Akhmadi14/Electro-Fenton-Reactor/presentasi/EFfiton_Poster_EEdays.jpeg

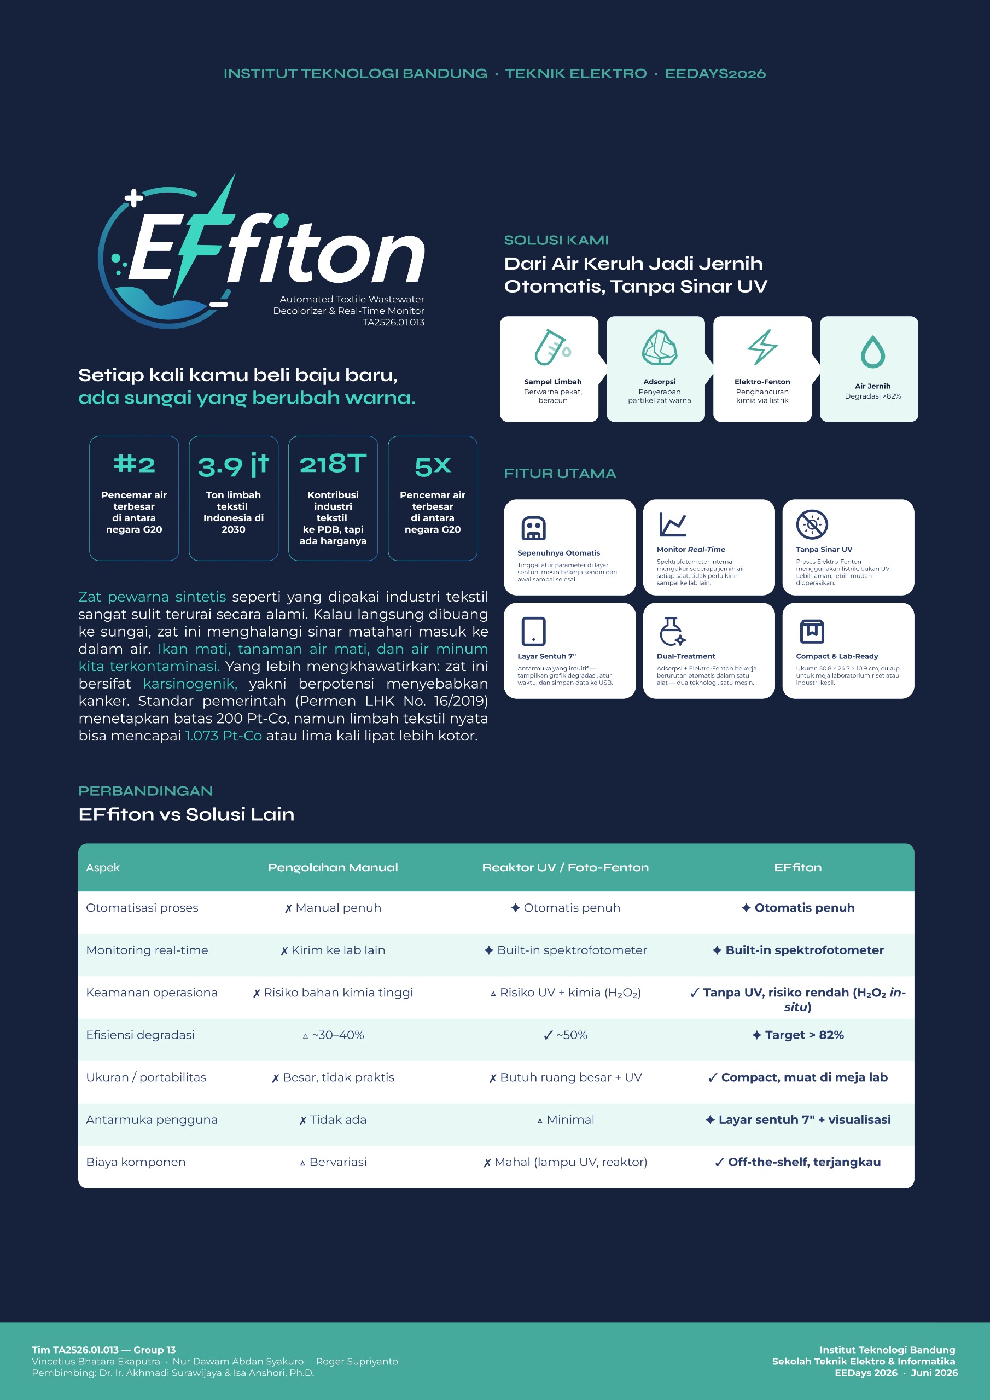
presentasi/EFfiton_Poster_EEdays.jpeg
