Akhmadi14/Electro-Fenton-Reactor/Rancangan/program_mikrokontroller/Reference/flowchart_pompa/alur_pompa-aerator.drawio.png

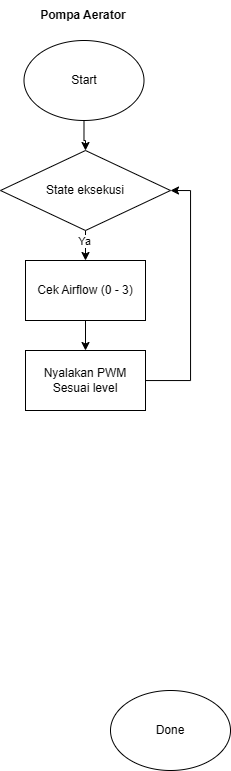
Rancangan/program_mikrokontroller/Reference/flowchart_pompa/alur_pompa-aerator.drawio.png
