Akhmadi14/Electro-Fenton-Reactor/Rancangan/program_mikrokontroller/Reference/flowchart_pompa/alur_pompa-h2so4.drawio.png

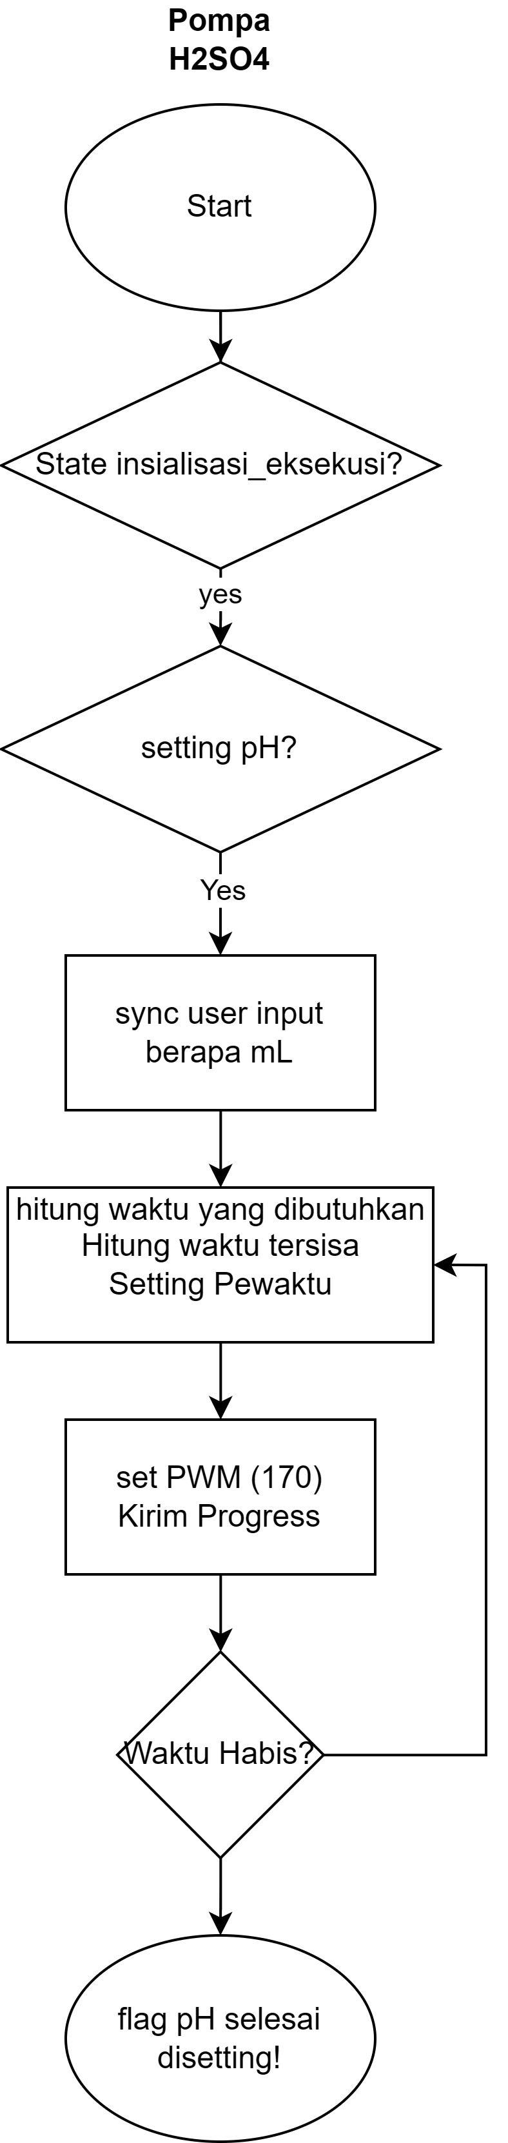
Rancangan/program_mikrokontroller/Reference/flowchart_pompa/alur_pompa-h2so4.drawio.png
