Akhmadi14/Electro-Fenton-Reactor/Rancangan/program_mikrokontroller/Reference/flowchart_pompa/flowchart_feso4.png

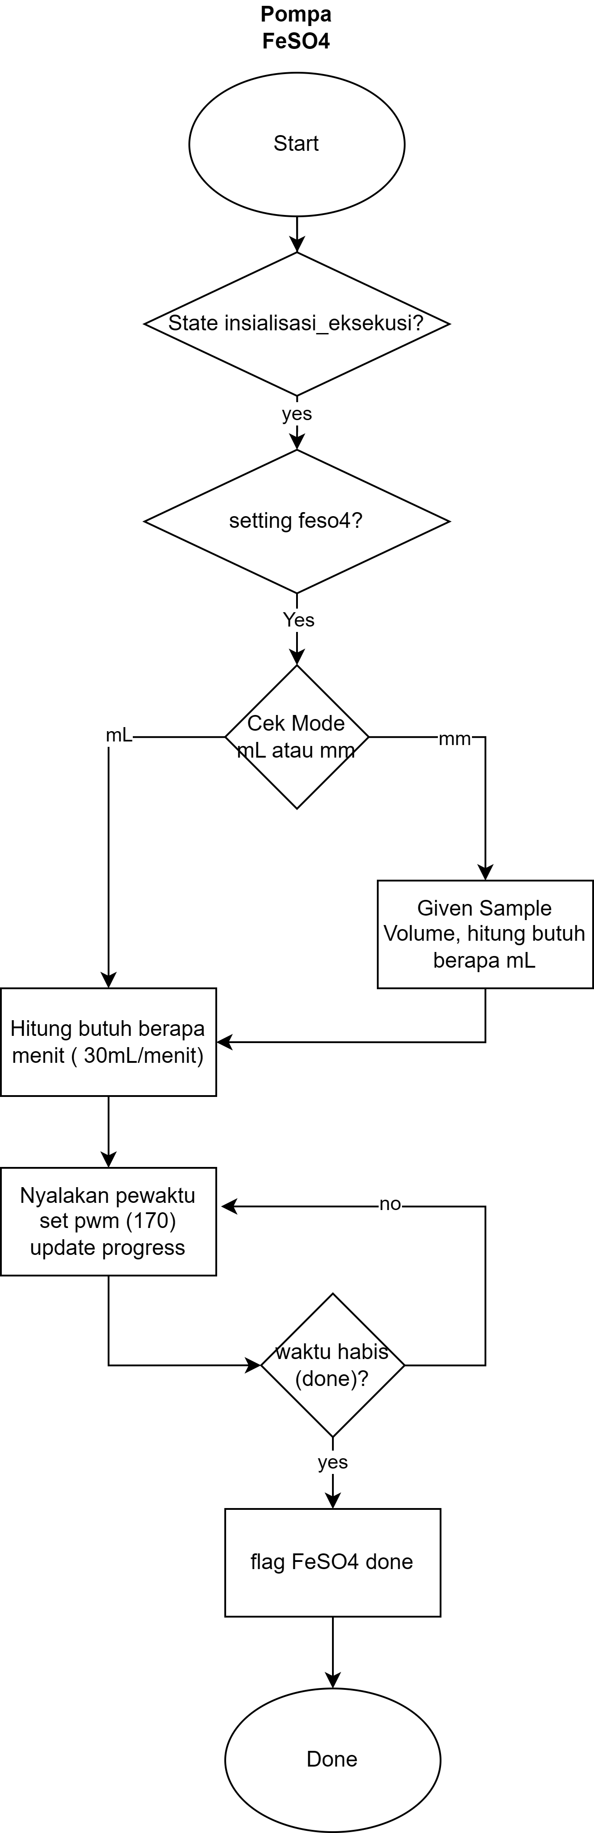
Rancangan/program_mikrokontroller/Reference/flowchart_pompa/flowchart_feso4.png
