Akhmadi14/Electro-Fenton-Reactor/Rancangan/program_mikrokontroller/Reference/state_eksekusi.png

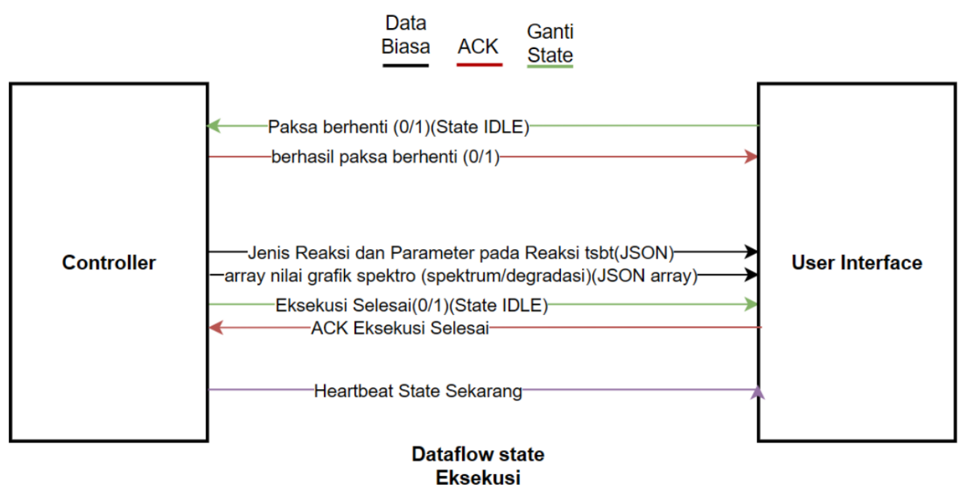
Rancangan/program_mikrokontroller/Reference/state_eksekusi.png
