Akhmadi14/Electro-Fenton-Reactor/Rancangan/program_mikrokontroller/Reference/state_flushing.png

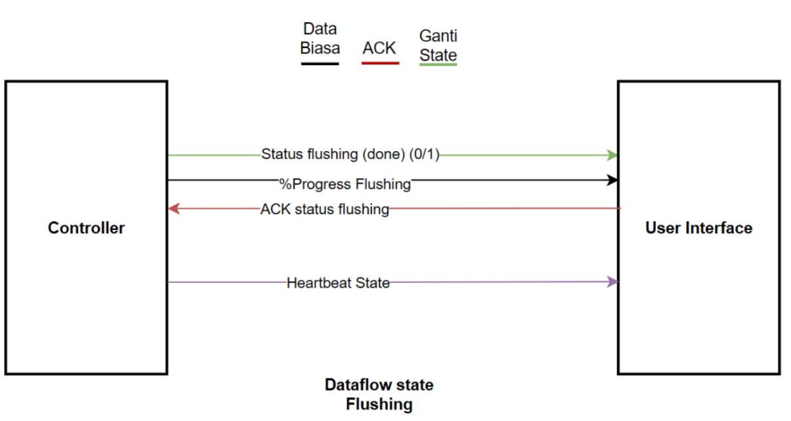
Rancangan/program_mikrokontroller/Reference/state_flushing.png
