Akhmadi14/Electro-Fenton-Reactor/Rancangan/program_mikrokontroller/Reference/state_idle.png

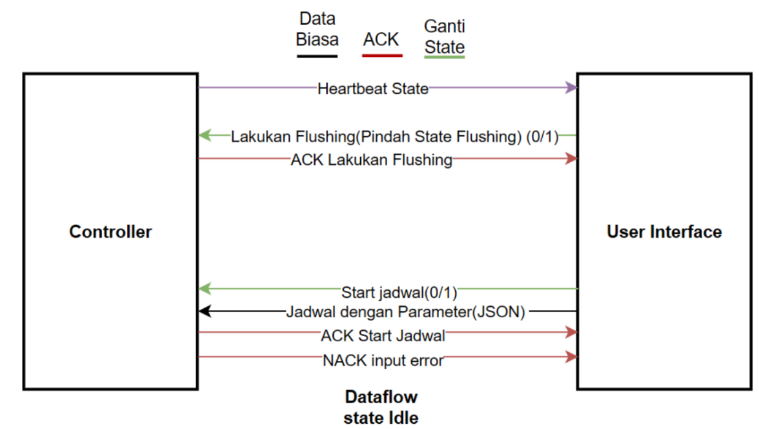
Rancangan/program_mikrokontroller/Reference/state_idle.png
