Akhmadi14/Electro-Fenton-Reactor/Rancangan/program_mikrokontroller/Reference/state_sistem.png

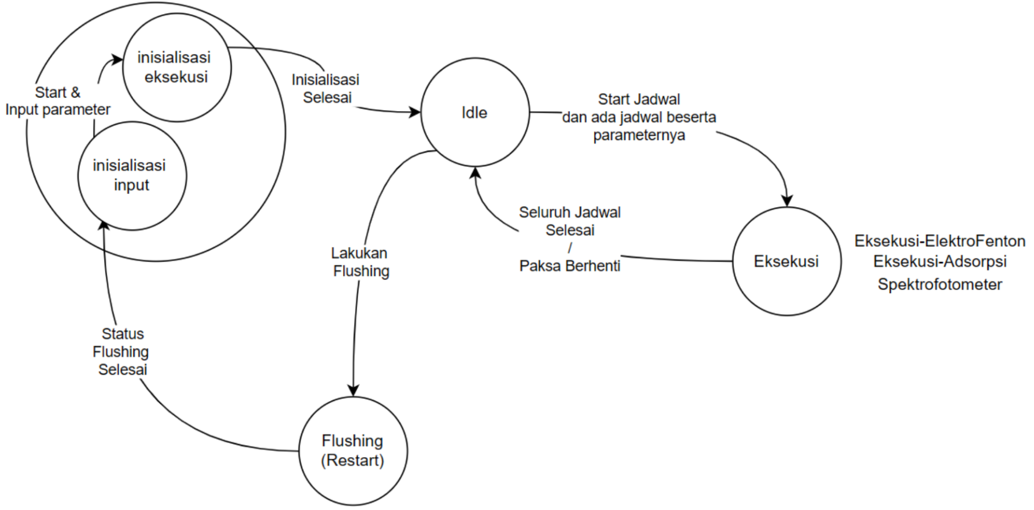
Rancangan/program_mikrokontroller/Reference/state_sistem.png
