Akhmadi14/Electro-Fenton-Reactor/Rancangan/program_mikrokontroller/Reference/state_sistem_2.png

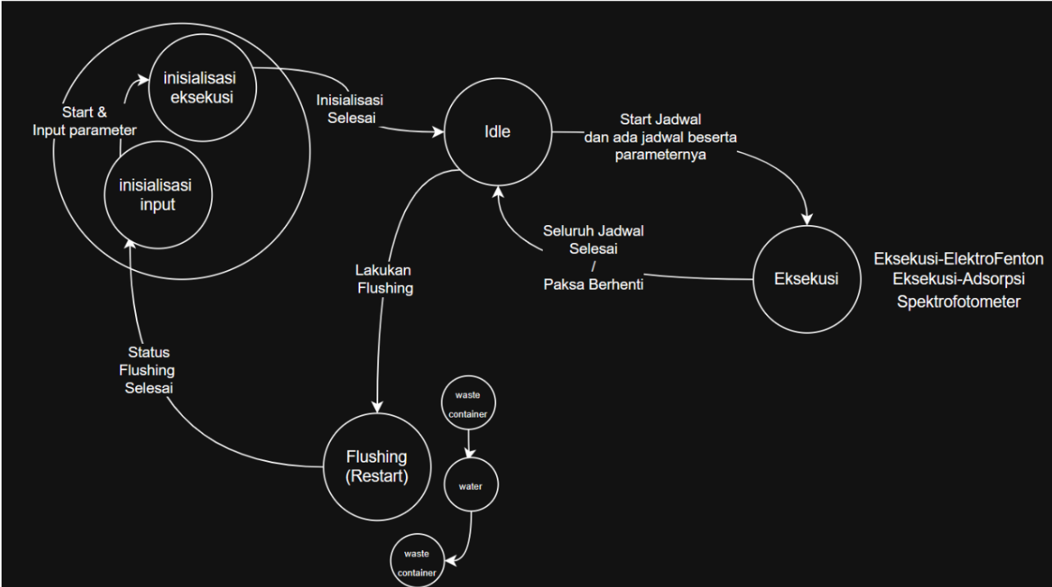
Rancangan/program_mikrokontroller/Reference/state_sistem_2.png
