Akhmadi14/Electro-Fenton-Reactor/(commit log)

2026-07-30 Create readme.md
    List RAB, BoM dll yang terkait anggaran
2026-07-30 Menambahkan program user interface
    [huge_app.csv]
2026-07-30 Menambahkan desain PCB
    [pompa.kicad_sch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]
2026-07-30 Dokumen presentasi, dan BOM
